danielamendezp/Magnetic-Levitator/Magnetic levitation system.pdf

Universidad Técnica Nacional

Electronic Engineering

Automatic Control Project

# Magnetic Levitation System

Tutor:

Kenneth Rojas Rodríguez

Students:

Keylor García Jirón

Emerson Molina Murillo

Shinji Rodríguez Rodríguez

Daniela Méndez Porras

William Sánchez Céspedes

2022

Introduction (D)

A magnetic levitator allows to sustain a magnetic load in suspension, it can be

obtained by applying current to an electromagnet that generates repulsion

between magnetic poles, starting from the control of the electromagnet it's

possible to maintain the load in the air at certain position. In this investigation, the

study of many tools in the field of engineering is incorporated. However, this field

is still under study, for the application in different areas of science and

engineering.

The project consists of making a design of a magnetic levitator, carrying out the

study of all the elements that are part of it, such as: the mathematical analysis

and use of the transfer function, the study and application of magnetic fields,

development of PID controller, design of electronic circuits, creation of code to

handle variables such as height position, object stabilization and processing of

different signals. The set of all these parts belongs to the implementation of a

physical model of the magnetic levitation system, considering the difficulties and

challenges generated using a great variety of fields of study in the project, as well

as the application of their respective solutions.

The main purpose of the project is to give the system the ability to control the

position of the levitating object, it must be able to make all the necessary

regulations and measurements automatically, making mathematical calculations

that help its proper functioning.

The characteristic of the system is that it will have a single sensor that measures

the height of the floating magnet is located, this magnet will be located just above

the electromagnet and permanent magnets will surround it, which between both

components will apply upward force and repulsion to maintain the permanent

magnet in the air. The floating magnet will be ideally centered and the only thing

that will be regulated will be the height.

Electromagnetic fields are force fields created because of the movement of

electric charges. The electromagnets will fulfill this function, since a coil will cause

a concentration of magnetic flux, more powerful, more stable, and controllable.

This control oversees modifying the electric current that circulates through it.

To effectively apply the stabilization of the levitator, it is necessary to consider its

position, to be processed, through code and the information contained in

mathematical analyzes such as the transfer function, the linearity that exists

between the magnitude of the current and magnitude of the magnetic field, in

other words, the force suffered by the load as a function of the current. Thanks to

obtaining this data, a precise controller can be designed numerically, however, a

series of tests allows the control to have a quick answer, damping changes and

to provide stability.

Throughout the project there were a series of changes in the design of the project

because they were found convenient during the realization of the mathematical

analysis. Changes such as the number of electromagnets, at the beginning of the

project it was projected with 4 electromagnets, by simplifying the mathematical

and physical calculations, thus improving the operation of the project with the

proposed design.

It is worth mentioning that 4 coils with different cable gauges were created, which

were changed at convenience due to the current conditions in which the magnetic

levitation system was working.

For the design of the levitator, the possible situations that could happen were

considered so that the performance could not be the desired. The heat conditions

that the coils can produce, as has been described the flux of current generates a

magnetic field, when placing the load, parasitic currents can be produced that

increase the amount of energy released in the form of heat, affecting the

components and the structure. In addition, the precision during the construction

of the electromagnet can be a fundamental aspect for the correct operation of the

system, also there are other components to consider, including: sensor reliability,

signal noise, etc.

During the project, the team is organized into subgroups consisting of two people,

each of whom must oversee at least two topics, generally related to support

among members, of the same or different groups. As mentioned above, the

important aspects of the tasks to be performed are code developing,

mathematical analysis, electronic circuit design, electromagnet, and magnetic

force, as well as position and current measurement.

The idea in the distribution of tasks is the support between the members,

however, it is necessary that the specialists in each subject can correctly carry

out their tasks and also provide help in research and physical assembly of the

system elements. Therefore, the design, analysis, prototyping, construction or

assembly and testing are the 5 main stages to successfully achieve the project

performance.

To implement the project on a company the economic part is important, since it

needs to render accounts to the creditor to identify if the projects is feasible or

not to a company, according to the obtain benefits and the economic cost of this.

If the expenses exceed the benefits, then the project is not economically viable

for a company. The economic expectations can vary at the beginning of the

project compared to the end, since there is little information about the final

designs proposed.

Literature review:
Circuit of a magnetic levitation system: (D)
The current control of the electromagnet was carried out with the use of an N-

channel MOSFET in a configuration like a step down or buck circuit that helps to

reduce the value of the output voltage in relation to the input. Adding protection

elements such as a reverse polarity diode in parallel to the electromagnet.

It is possible to find that the frequency of 10kHz was used to switch the MOSFET

type transistor, guaranteeing current to the coil and providing smoothness in the

operation of the levitator and avoiding voltage peaks. Some problems with the

heating of the MOSFET transistor and the electromagnet are discussed, which

were solved by using heat sinks. [3]

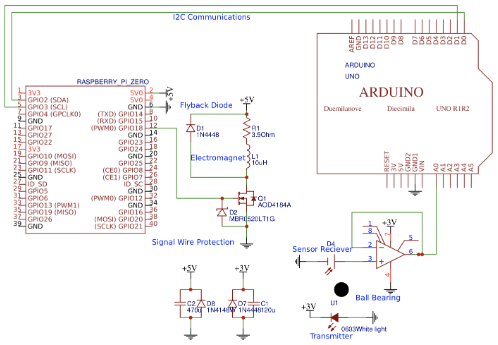
[picture p1: figure]

Figure 1. Magnetic levitation system circuit diagram. [3]

Controller design: (E)

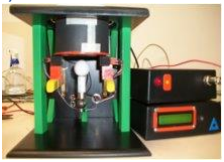
[picture p2: figure]

Figure 2. Design and construction of a magnetic levitation system controlled by

a PID algorithm. [7]

The PID controller exerts a control signal that depends on an error value

calculated as the difference between the desired signal and the system output.

There must be a signal proportional to the error if the output is far from the

reference signal (P = Kpe(t)).

In addition, a control action is needed that acts before the accumulation of the

error, when it becomes constant, which causes the system to act to improve the

response of the system in a steady state with a tendency to the reference signal

Finally, the derivative control action acts against changes in the system output

over time and tries to anticipate these changes

So, the general form of the PID is:

Figure 3. PID equations. [7]

Design Two-Dimensional Magnetic Levitation Control System: (S)
In this thesis they analyze 2 different systems, one is a simple levitator that has

only 1 electromagnet and a steel ball levitating. The other system is with 2

electromagnets, applying 2 different currents for each electromagnet. They also

analyze the stability of the system and how can linearize this system and maintain

the ball levitating.

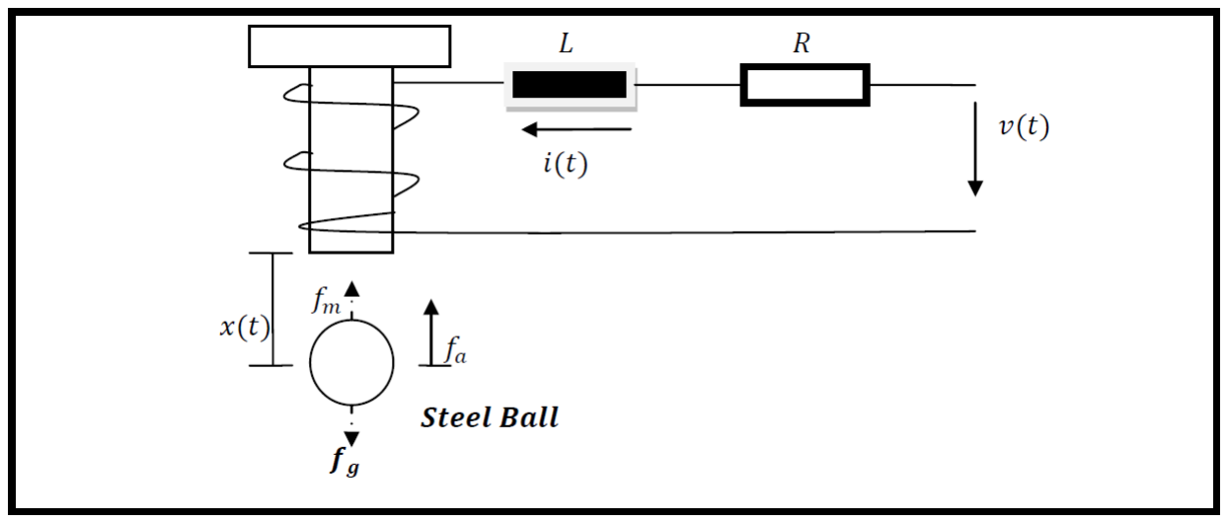
[picture p3: figure]
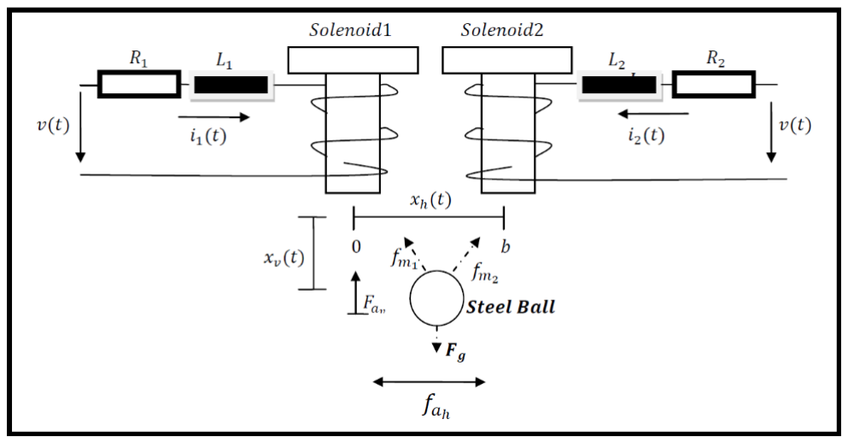
[picture p4: figure]

Figure 3. System diagram.

Project Management
Organization of work teams: (D)
The team was organized in such a way that each one of the members shared at

least one of the tasks with another member, with the aim of dividing the workload

and having support among colleagues due to the high complexity of the project.

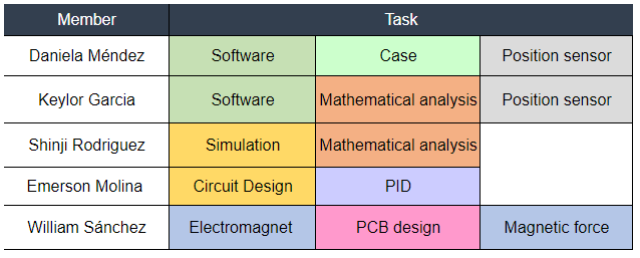
[picture p5: figure]

Table 1. Task division by person.

Gantt Diagram: (D)
The Gantt Diagram schedules each of the tasks to be carried out by the team in

the expected time to project final presentation, it is also possible to have control

of late tasks and tasks to be carried out. The blue color indicates the activities in

the planned time, on the other hand, the red color indicates delayed tasks.

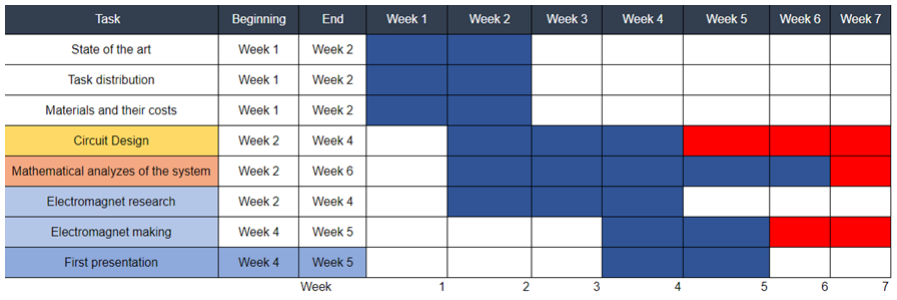
[picture p6: figure]

Table 2. Gantt Diagram from week 1 to week 7.

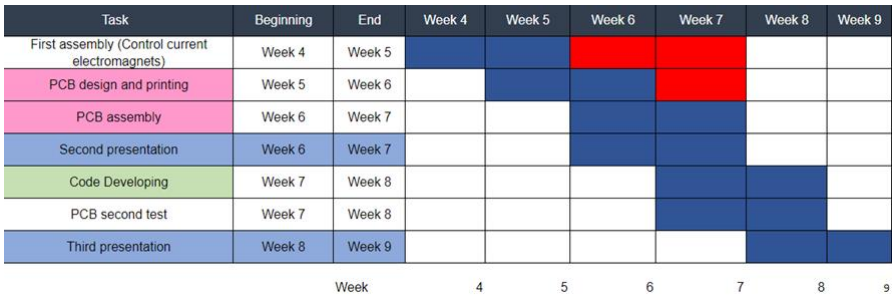
[picture p7: figure]

Table 3. Gantt Diagram from week 4 to week 9.

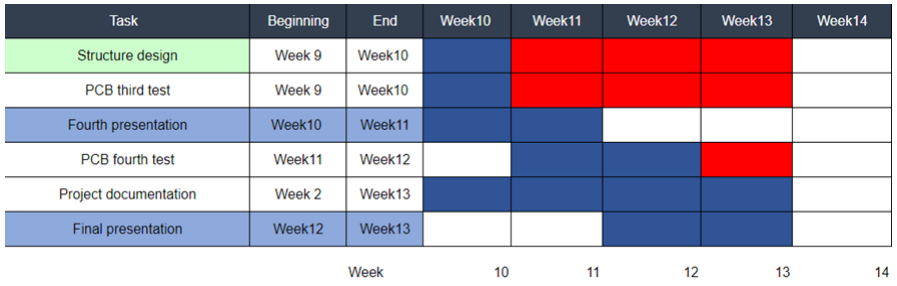
[picture p8: figure]

Table 4. Gantt Diagram from week 10 to week 14.

There were some tasks that were delayed because of the changes to the design

of the project and some complications mainly generated because of

mathematical and physical calculations. Due to the complexity of the project and

the time the research took to find good and reliable information that could be

applied to the needs of the project.

Methodology:
The creation of a levitron is requested, which will fulfill the function of keeping a

magnet floating, it must have a regulation of its height and stability by using a PI,

PD or PID controller.

To carry out what was requested, a mixed research methodology was used where

both the qualitative and quantitative parts were used. This is because qualitative

aspects of the materials to be used and the physic-mathematical aspect of

situations that influenced the levitron system had to be fulfilled.

Specifications of the magnetic levitation system:
Description
Number of coils turns | 470
Cable gauge | 24AWG
Electromagnet size | 30mmx25mm
Magnets | Neodymium N35
Number of coils | 1
Number of magnets | 8x5
Distances between magnets and electromagnet | 49mm
Maximum current | 3A
Maximum separation distance in air | 10mm
Voltage | 12V

Table 5. Specifications of the magnetic levitation system

The previous table will show the specifications that the levitation system and the

electromagnet must comply with. The latter must have these specifications for

proper functioning since the magnet will be levitated on it.

Block Diagrams: (K)

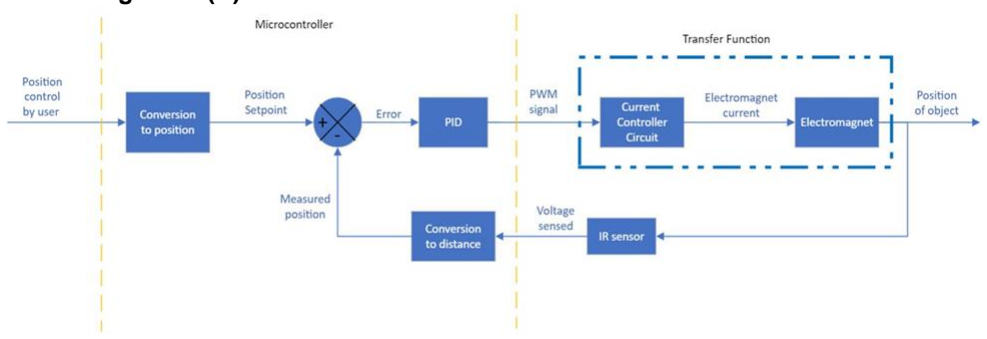
[picture p9: figure]

The block diagram shows the different parts that allow the magnet levitation

height to be controlled, the section consists of two large blocks: the

microcontroller and the transfer function. The levitation height is defined in the

microcontroller, and it is the output of the PWM signal to control the current

variation with respect to the position, the position of the magnet is compared with

the position defined by the user by means of an infrared sensor that determines the distance to which the magnet is located, and the error will be the difference

between these aspects.

Economic Cost: (D)
The cost of the materials was registered to keep track of the components used

for future implementations and improvements of the system. To implement the

project on a company the economic part is important, since it needs to render

accounts to the creditor to identify if the projects is feasible or not to a company,

according to the obtain benefits and the economic cost of this.

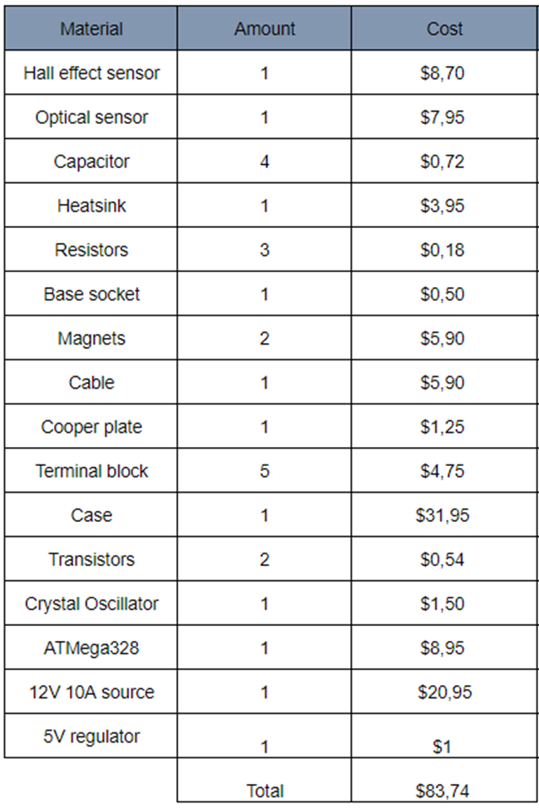
[picture p10: figure]

Table 6. List of materials and their cost.

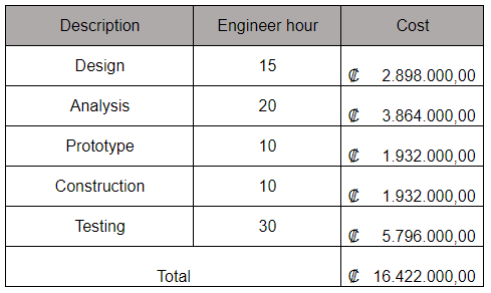
[picture p11: figure]

Table 7. Cost of the engineer hour.

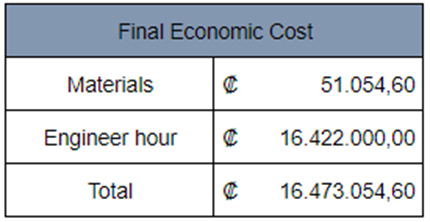
[picture p12: figure]

Table 8. Final economic cost of the project.

As you can see the cost of the material is not that high, however, the most

expensive thing is the hours dedicated to the project, due to the cost of the

engineer hour, being ₡32.200. Owing to the complexity and the time that it takes

to do all the calculations, measurements, the design and the testing considering

changes doing to simplify.

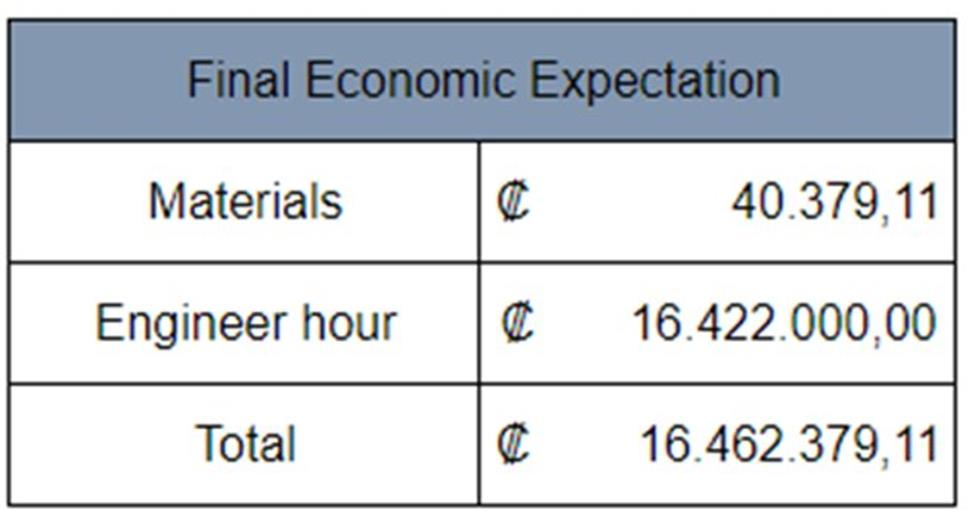
[picture p13: figure]

Table 9. Final economic expectation of the project.

At the beginning of the project approach, an estimate of the costs was calculated,

however, since there is little information about the final designs proposed, the

economic expectation varies from the beginning and at the end of the project. For

this reason, if we compare Table 8 and Table 9, it’s possible to observe different

totals between each of the tables, however, the difference varies by approximately ₡10,000 in material costs.

Theoretical concepts:
For the development of the project an electromagnet was used because it has

the properties experienced by electrical conductors, a current flow through the

conductor and a magnetic field is generated. In addition to being a magnetic

levitation system, this device was used as a pillar for its development.

The electromagnet is a type of magnet in which the magnetic field is generated

by the circulation of an electric current through a conductor. Its superiority over

the permanent magnet lies in the fact that the intensity of the field generated

depends on the amount of current flowing through it, and it is possible to control

its behavior. However, in applications in which it is not necessary to modify the

magnetic field or make it disappear, the permanent magnet is superior, since it

can generate larger fields at the same size.

It was invented in 1825 by a British electrician named William Sturgeon. He based

it on the studies of Hans Christian Ørsted, a Danish physicist who discovered that

the flow of an electric current through a conductor generates a magnetic field

around it. Sturgeon's electromagnet consisted of a horseshoe-shaped (or U-

shaped, to bring the poles closer together and concentrate the lines of magnetic

force) insulated piece of metal wrapped in a coil: a spiral of conductor with many

turns (the more turns the coil has, the more powerful the electromagnet). An

important advance in the evolution of the electromagnet was thanks to Joseph

Henry, an American scientist who changed the iron insulation for conductor

insulation, achieving better results than Sturgeon. In addition, he discovered the

principle of electromagnetic induction in parallel with Faraday, although it was

published earlier by Faraday. He put into practice his knowledge of

electromagnetism to help Morse develop his telegraph based on the

electromagnet. However, it is not necessary to insert a metal part into the coil to

make an electromagnet. An "empty" coil is called a solenoid, with each pole at

one end. The reason for introducing a metallic material (usually iron) inside the

coil is that the field generated is much stronger at the same current intensity. This

effect, known as ferromagnetism, occurs because materials of this type contain

small magnetized zones (domains) that are initially disordered. The magnetic

field of the solenoid arranges them, so that the iron becomes a magnet, and its

effect is added to that of the coil. When the coil field disappears, the domains usually become disordered again, but some materials are remanent, i.e., they

remain magnetized for a while.

Because of their versatility, electromagnets have enabled the emergence of

numerous electronic devices, and important industrial applications have arisen.

The invention of the electric telegraph was made possible precisely thanks to the

electromagnet, and electric motors transform electrical energy into kinetic energy

through the operation of several electromagnets together. Thanks also to their

ability to vary the magnetic field, they are used in loudspeakers and storage

devices. However, the most powerful applications are industrial ones, such as the

separation of materials, the cleaning of contaminated water, magnetic levitation

trains, current generators, or the transport of heavy materials. [11]

As mentioned, the electromagnet is a magnet, where the magnetic field is

generated by electric current, and the current passing through a wire creates a

magnetic field around it, these have advantages in their use and over other similar

devices, although it is also important to have certain considerations in their use,

such as heat.

Unlike common magnets, electromagnets heat up. These artificial devices do

everything a magnet can do and much more; and they are particularly useful

because they can be made to have any desired field strength and can be made

to become stronger or weaker or even turn off. Basically, electromagnets are coils

of wire wrapped around a metal core, which in turn are connected to a battery.

While they are easy to make, they can have a problem with overheating if given

more voltage than their wires can handle. Fortunately, with careful design, this

problem can be avoided. [12]

Electromagnet is called the device that has the property of acquiring magnetic

properties when its coil is crossed by an electric current. [8] Therefore, it easily

transforms electrical energy into mechanical energy.

Used in the project as the central magnet, on which the object to be placed in the

project will levitate. This has an external circuit that allows the regulation of the

current that enters the winding of the electromagnet created.

Magnetism is called the part of electricity that studies the properties of magnetic

fields and the behavior of bodies that are subjected to these fields. [8]

This phenomenon should have been taken into consideration when placing the

magnets that are around the central electromagnet, the attraction or repulsion

that the object has on each of the base magnets is essential in the levitation that

can occur.

The lines of force of a magnet are invisible lines that can be seen by scattering

iron filings in a magnetic field, leaving one pole of the electromagnet and going

to the other pole in a beam. [8] These lines become unobservable, but they occur

since a magnetic field is created in the magnetic levitator.

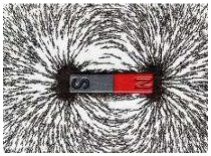
[picture p14: figure]

Figure 4. Representation of lines of force [9]

Magnetic flux is the total number of lines of force that cross any section of a

magnetic circuit.[8] In the case of the magnetic levitator, the field lines pass

through the object that will be found hovering over the electromagnet.

Magnetic permeability is the relationship between magnetic induction and the

corresponding magnetic field intensity determined on the magnetization curve.

[8]. It is used in the force formula for the object to be held in levitation.

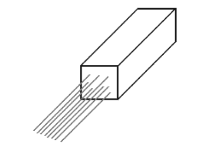
[picture p15: figure]

Figure 5. Representation of the magnetic flux [8]

Magnetic flux. It is defined as the surface integral over the normal component of

the magnetic field where Φ is the magnetic flux, B the magnetic induction, gives

the surface area differential and n the norm. The magnetic flux is analogous to

the electric field, it is also represented as arrowhead lines, which run from the

north to the south pole of the magnet. For a magnetic induction B and a constant

area A. [13]

Magnetic susceptibility. In many isotropic and linear materials there is a

relationship between magnetization (M) and magnetic field strength (H), where

xm is the magnetic susceptibility. According to their magnetic susceptibility

materials are classified into paramagnetic if xm > 0, being the magnetic induction

enhanced and into diamagnetic if xm < 0, in which the magnetic induction is

weakened, xm can vary drastically with temperature, in general xm is quite small

(|xm| 1) for diamagnetic and paramagnetic materials. [13]

Self-inductance. Occurs in a coil when the current flowing through it is varied,

inducing an electromotive force on itself. In a coil of N turns, through which

circulates a current I, the inductance, where l is the length of the coil and Φ the

magnetic flux present in it. Considering Faraday's law, the self-inductance in a

coil gives rise to a counterelectromotive force [13].

Magnetic circuits. If we consider a well-defined path for a magnetic flux (as in the

case of ferromagnetic materials), a magnetic circuit can be considered. A closed

circuit of ferromagnetic material excited by a series of wire loops through which

a current flow represents a magnetic circuit. The magnetomotive force is given

by fmm = NI, where N is the number of turns of the coil and I, the current flowing

through it. The reluctance is defined as < = R dl µA, where dl is the length

differential and A the cross-sectional area in question. Analogous to Ohm's circuit

law and Φ being the magnetic flux. [13]

Ferromagnetic material: are substances that possess a great magnetism,

capable that a magnet remains adhered to it.

Electromagnetic field: These are a combination of invisible electric and magnetic

force fields. They occur both naturally and due to human activity.

Inductance: Inductance is the property of an electrical circuit to resist changing

current. A current flowing through a wire has a magnetic field around it.

Magnetism: Magnetism is a physical phenomenon whereby objects exert

attractive or repulsive forces on other materials.

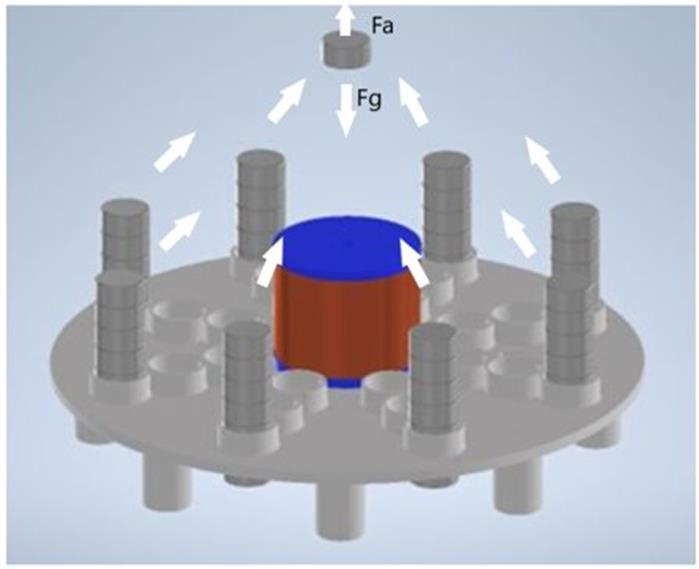
[picture p16: figure]

Figure 6: Force diagram.

Each magnet has independent forces, which when united in a single mass, in this

case according to the previous image is observed as a tower of magnets placed

on the base that would act as permanent magnets.

These permanent magnets exert independent forces oriented to the same

direction on the magnet that is in a state of levitation, where this magnet has its

forces such as gravity, for example.

So, in the circuit sketch was made use of an electromagnet, which is a device

capable of generating magnetic fields using electric currents in its windings.

The electromagnet together with the permanent magnets will allow the interaction

of the forces and the regulation of the height of the levitating magnet.

Mathematical calculations and measurement
Electromagnetic field measurements: (D)
The electromagnetic field measurements were made using a hall sensor, where

it can measure the fields at different distances. This sensor works by generating

an output voltage which will be proportional to the product of the strength of the

magnetic field and the current.

If the value of the current is known, then the strength of the magnetic field can be

calculated; If the magnetic field is created by using a current flowing through a

coil or a conductor, then the value of the current in the conductor or coil can be

measured.[10] Applying this concept, the measurement of the magnetic field of

the electromagnet used was carried out, relating at the same time the magnitude

of the magnetic field to different measured currents and different distances.

For the measurement of the magnetic field of permanent magnets, the same

concept was used, but applying the relationship between the magnetic field and

the distance, this was measured to obtain the magnetic moment of the permanent

magnets found in the base. Whose equation is:

μ =

B⋅X

3
2x10⁻⁷

Equation 1. Dipole moment of a magnet.

This dipole moment constant will help to apply the formula for the force exerted

by the 8 permanent magnets. This will help in mathematical calculations, since

it's intended to obtain the value of the forces that will be exerted on the magnet

that will be in the air.

Obtaining these values, was written down with their distance, current and

magnetic field variations to obtain a representative equation whose variable

would be height and current in the case of the electromagnet.

For this measurement, a printed system was built, which can be seen in Figure

7. It helped to obtain the highest possible precision in the data, since this will

determine if the height adjustments that the levitator needs will be precise.

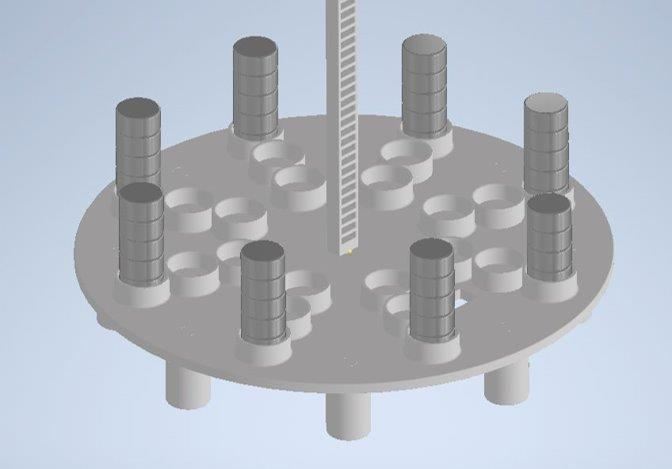
[picture p17: figure]

Figure 7. The design was made to measure the magnetic field at different

distances.

As can be seen, the measurements were made at different distances and heights,

to obtain the distance referring to the position of the permanent magnets with

respect to the center of the electromagnet and to analyze at what determined

distance is the ideal magnetic field to be able to provide the floating magnet a

greater difference in height to which can be regulated.

The measurement of the magnets was also carried out at different positions with

respect to the center of the magnet to obtain a measurement that was closer to

the ideal behavior of a magnetic field at different heights, since this, as mentioned

above, would help mathematical calculations to be more accurate and therefore

the height control was more precise.

Current measurements: (K)
For current control, it was determined that the most appropriate way to do it is by

implementing a PWM-controlled mosfet transistor to vary the current that reaches

the electromagnet and limit it so that it does not exceed levels that could

compromise the cables and the electromagnet.

This control is essential since it will allow you to vary the height of the magnet

that is levitating, pushing or attracting it as necessary.

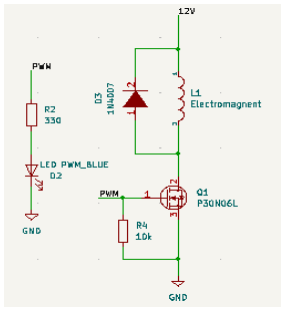
[picture p18: figure]

Figure 8. Schematic of the current control for the electromagnet.

A simulation was carried out in the LTspice software to observe the reaction of

the circuit with respect to the input PWM signal, as shown in figure 8, the current

(red signal) increases according to the variation of the pulse width. PWM (green

signal). The simulation contains the final design for current control because with

the progress of the project it was modified according to the needs, the frequency

of the pwm signal was defined at 31kHz.

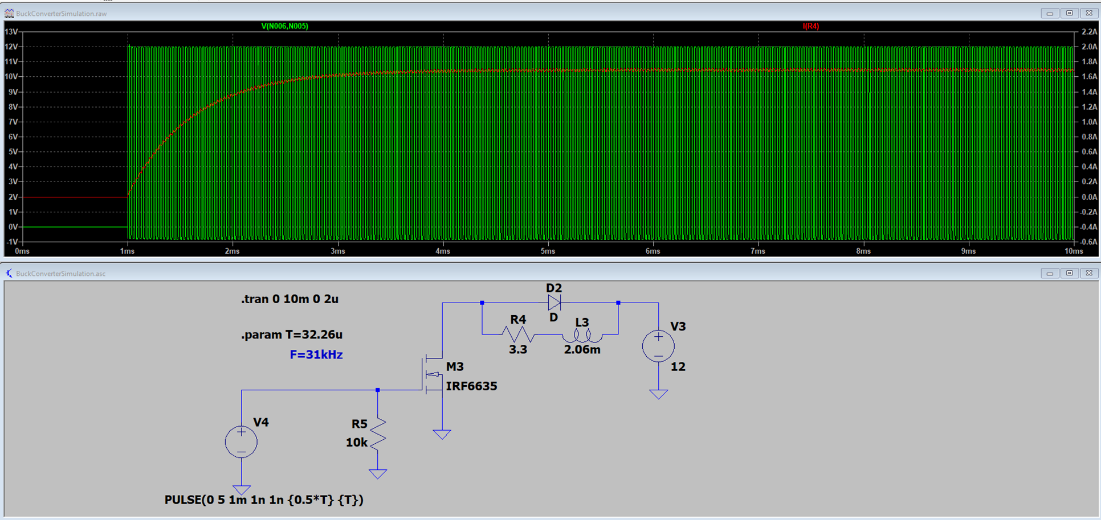
[picture p19: figure]

Figure 9. Current simulation in LTspice.

Mathematical and physical analysis: (S)
After measuring the magnetic field of 8 permanent magnets, we obtained the

equation y=0.0338*exp(-96.24x); where y is the representation for the magnetic

field and x the distance away from the magnet. And for the electromagnet using

1A is y= 0.0695*exp(-129.02x).

And calculating the force between the 8 permanent magnets and levitating

magnet, and force between electromagnet and levitating magnet applying this

formula:

Where:

fm: magnetic force

μb: magnetic permeability of the levitating magnet

ℎb: levitating magnet height

b: levitating magnet radius

d: distance between magnets in z axis

Bρ

(z): magnetic field of 8 magnets of electromagnet

For mathematical analysis we will need net forces:

fa = fm − fg

Where:

- Magnetic force (using the previous integral equation for the force):

fm = f8m + fem

f8m: 8 fixed magnets force

fem: electromagnet force

fm = 1.9112e

−96.42z − i ∗ 3.9598e

−129z

- Gravitational force:

fg = mg

fm = 2

μb
bℎb

∫ Bρ
(z)dz

d+ℎb⁄2

d−ℎb⁄2

- Acceleration force

fa = m

d

2
z
dt

2

The equation of motion for the levitating magnet is given by

m

d

2
z
dt

2 = fm − mg

Substituting magnetic force in the equation:

m

d

2z
dt

2 = 1.9112e

−96.42z − i ∗ 3.9598e

−129z − mg

→

d

2
z
dt

2 =

1.9112e

−96.42z
m

−

i ∗ 3.9598e

−129z
m

− g

While the equation for the electrical circuit is given by:

L

di
dt = −Ri + Vinavg

→

di
dt = −

R
L

i +

1
L

Vinavg

For the equilibrium point we have:

d

2z
dt

2 = 0 and di
dt

= 0

Substituting the acceleration:

0 =

1.9112e

−96.42z
m

−

i ∗ 3.9598e

−129z
m

− g

=> ie =

1.9112e

−96.42ze − mg
3.9598e

−129ze

And substituting di/dt

0 = −Ri + Vinavg

Vinavg = Rie = R [
1.9112e

−96.42ze − mg
3.9598e

−129ze

]

These equations are nonlinear equation, so we need to initialize them, in order to

obtain a linear model of the system, we will use Taylor Series Expansion of the

first two terms

d

2
z
dt

2 = a1

(z − ze

) + a2

(ż− że

) + a3

(i − ie

) + b(v − ve

)

a1 =

∂f1
∂z

|equil =

∂

∂z (
1.9112e

−96.42z
m

−

i ∗ 3.9598e

−129z
m

− g) |equil

=

−184.278e

−96.48ze
m

+

ie ∗ 510.8142e

−129ze
m

a2 =

∂f1
∂ż

|equil =

∂
∂ż

(
1.9112e

−96.42z
m

−

i ∗ 3.9598e

−129z
m

− g) |equil = 0

a3 =

∂f1
∂i

|equil =

∂
∂i̇

(
1.9112e

−96.42z
m

−

i ∗ 3.9598e

−129z
m

− g) |equil =
3.9598e

−129ze
m

b =

∂f1
∂v

|equil =

∂

∂v (
1.9112e

−96.42z
m

−

i ∗ 3.9598e

−129z
m

− g) |equil = 0

We note that the equation for the electrical part of the system is already linear.

Now define the following variables

x1 = (z − ze

); x2 = (ż − że

); x3 = (i − ie

); u = (v − ve
)

Where:

x1 = Magnet position

x2 = Magnet velocity

x3 = Drive current

u = Input average voltage

Whit this equation we can define a transfer matrix to obtain the transfer function

of the behavior of this system.
[

x1

̇
x2

̇
x3

̇

] = [

0 | 1 | 0
a1 | 0 | a2
0 | 0 −
| | R
| | L

] [
x1
x2
x3

] + [

0
0
1
L

] u(t)

y = x1 = [1 0 0][

x1
x2
x3

] + 0

And after calculating this transfer matrix we obtained this transfer function:

G(s) =

a2
L
s

3 +

R
L

s

2 − a1s −a1

R
L

We specify the following design parameters:

R = 3.3Ω; | L = 0.00206H; | m = 0.0028kg; | g = 9.81

m
s

2
For ze = 0.01m + 0.0225m(offset from center of tℎe electromanget) = 0.0325m

ie =

1.9112e

−96.42ze − mg
3.9598e

−129ze

ie =

1.9112e

−96.42∗0.01 − 0.0028 ∗ 9.81 3.9598e

−129∗0.01

ie = 0.6433383A

Vinavg = Rie = R [
1.9112e

−96.42ze − mg
3.9598e

−129ze

]

Vinavg = 3.3 ∗ 0.6433383

Vinavg = 2.123V

a1 =

−184.278e

−96.48ze
m

+

ie ∗ 510.8142e

−129ze
m

= 7228.70173

a2 =

3.9598e

−129ze
m

= 389.291874

G(s) =

a2
L
s

3 +

R
L

s

2 − a1s −a1

R
L

G(s) =

188976.6379
s

3 +1601.941748s

2 − 7228.70173s −11579959.08

For apply a PID control, we will use this equation for the PID:

C(s) = Kp +

Ki
s

+ Kds

C(s) =

Kds

2 + Kps + Ki
s

Calculating the close loop transfer function:

CLTF(s) =

C(s)G(s)
1 + C(s)G(s)

CLTF(s) =

(
Kds

2 + Kps + Ki
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
2 − a1s − a1

R
L

)

1 + (

Kds

2 +Kps +Ki
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
2 − a1s − a1

R
L

)

CLTF(s) =

a2
L

(Kds

2 + Kps + Ki)

s(s

3 +

R
L

s

2 − a1s − a1

R
L

)

s (s
3 +

R
L

s

2 − a1s −a1

R
L

)+

a2
L

(Kds

2 + Kps + Ki)

s(s

3 +

R
L

s

2 − a1s − a1

R
L

)

CLTF(s) =

a2
L

(Kds

2 + Kps + Ki)

(s
4 +

R
L

s

3 − a1s

2 − a1

R
L

s) +

a2
L

(Kds

2 + Kps + Ki)

CLTF(s) =

a2
L

(Kds

2 + Kps + Ki)

s

4 +

R
L

s

3 +(Kd

a2
L

− a1) s
2 + (Kp

a2
L

−a1

R
L

)s + Ki

a2
L

)

Where:

2δωn = Kp

a2
L

− a1

R
L

ωn

2 = Ki

a2
L
We will omit Kdsince it is not within the current analytical capabilities, so we can

rewrite the equation as follows

C(s) =

Kps + Ki
s

CLTF(s) =

(

Kps + Ki
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
2 − a1s − a1

R
L

)

1 + (

Kps + Ki
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
2 − a1s − a1

R
L

)

CLTF(s) =

a2
L

(Kps +Ki)
(s
4 +

R
L

s

3 − a1s

2 − a1

R
L

s) +

a2
L

(Kps +Ki)

CLTF(s) =

a2
L

(Kps + Ki)

s

4 +

R
L

s

3 −a1s

2 + (Kp

a2
L

− a1

R
L

)s + Ki

a2
L

)

ts =

3
δωn

→ δωn =

3
ts

→ ωn =

3
tsδ

2δωn = Kp

a2
L

− a1

R
L

→

6
ts

=

Kpa2 − a1R
L

Kp =

6L + a1Rts
tsa2

=> Kp = 61.276

(

3
tsδ

)

2
= Ki

a2
L

Ki = (

L
a2

) (

3
tsδ

)

2
=> Ki = 132.289; para δ = 0.6

Ki = 97.2; para δ = 0.7

Ki = 74.4; para δ = 0.8

Ki = 58.8; para δ = 0.9

Designs
Schematic Design: (K)

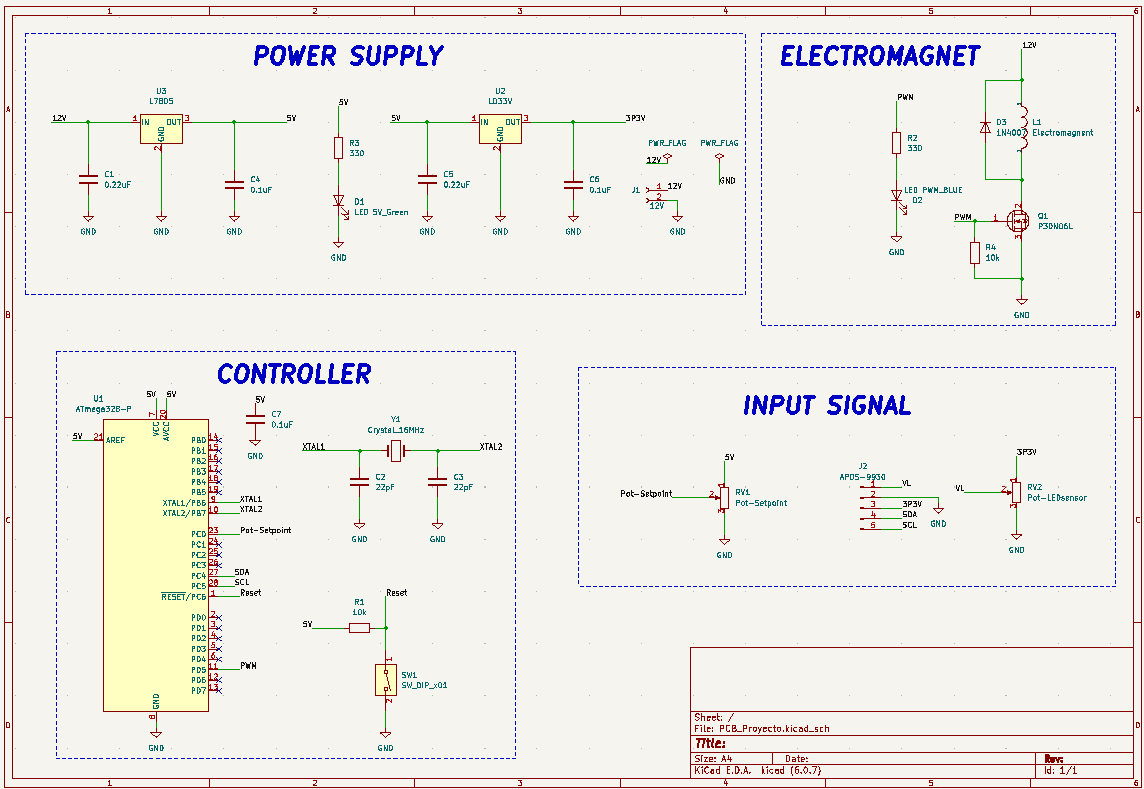
[picture p20: figure]

Figure 10. Schematic Design

The circuit design was divided into four parts, a control part, a power part, the

electromagnet and the input signal, where each one fulfills a specific and

important function within the circuit.

In the control stage all the power supplies of the circuit, there you can find the

components responsible for feeding or regulating the other components so that

they can operate properly.

The control stage is responsible for the operation of the circuit, this part uses the

energy generated by the previous stage to achieve the actuation of the

components, controlling their functions within each stage of the device, in our

case the main component of the control stage is an ATmega.

The electromagnet part is responsible for generating a magnetic field that arises

from the circulation of an electric current through a conductor. This, together with

the permanent magnets, manages the intensity of the field, which depends on

the amount of current flowing.

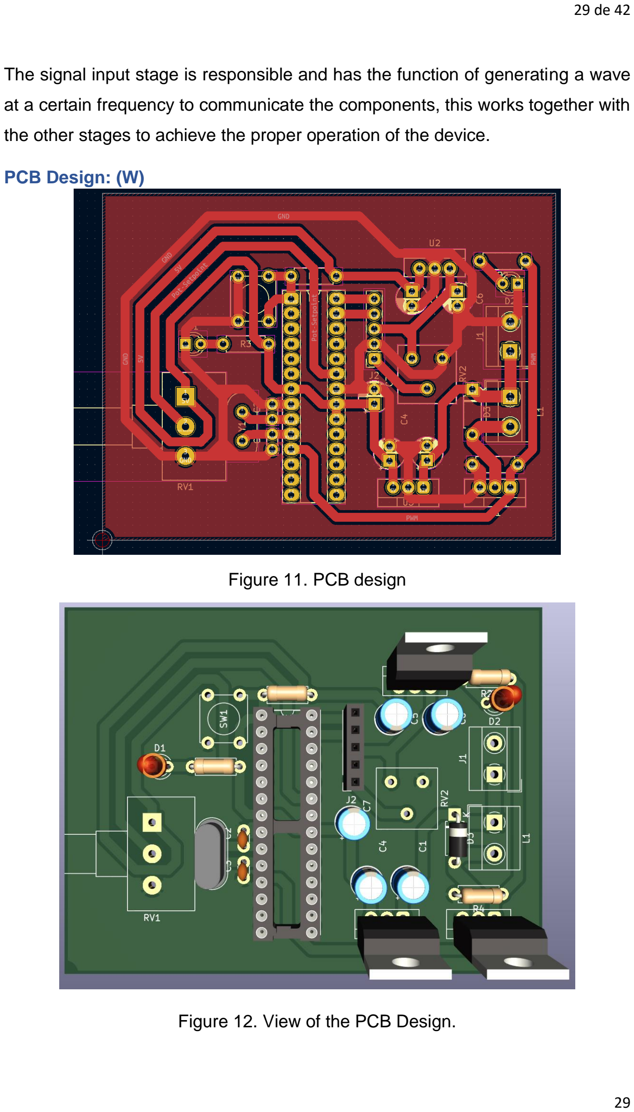
[picture p21: page 29]

The signal input stage is responsible and has the function of generating a wave

at a certain frequency to communicate the components, this works together with

the other stages to achieve the proper operation of the device.

PCB Design: (W)

Figure 11. PCB design

Figure 12. View of the PCB Design.

For the design of the PCB was used KiCad software because it is a very versatile

software and with a very wide gallery of components, then once designed the

circuit allows you to create the PCB as such, where once placed all the pieces

can accommodate your own taste and design the respective tracks; these tracks

can be expanded to the thickness this in order that when printed on the CNC

machine avoids any malformation of this.

In figure 11 you can see one of the different layers of the PCB, this shows the

design of how the connections will look like, the holes where each component will

go, the parts that will have copper, those that will not and the actual size of the

piece.

In Figure 12 you can see a schematic of how the circuit will be with the assembled

components, this is remarkable of KiCad software because it allows users a

realistic view of the project they are working on, so it is easier to make changes

of positions or different modifications.

Structure design: (D)
The physical structure was designed with the Autodesk company's Inventor

program, which allowed the design of all the structures made during the project,

both in tests during the process, measurement structures for precision, and the

final structures that provide the project, stability, magnet location facilities, space

for cables, sensor support, circuit boards, likewise it’s part of the electromagnet

support.

These were designed and printed with the objective of resisting the temperatures

generated by all the circuitry, therefore, they were printed in PETG, whose

resistance provides the project with the conditions not to melt or damage

elements in the process.

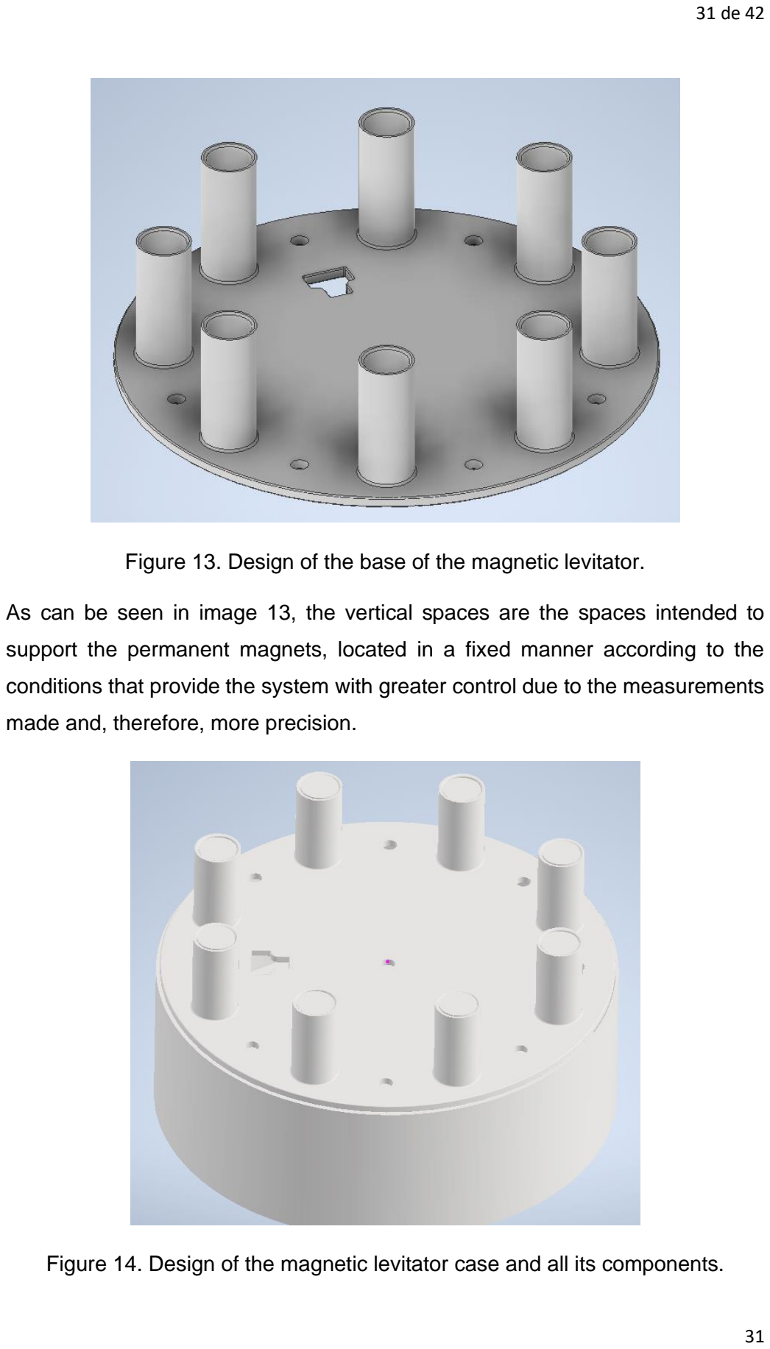
[picture p22: page 31]

Figure 13. Design of the base of the magnetic levitator.

As can be seen in image 13, the vertical spaces are the spaces intended to

support the permanent magnets, located in a fixed manner according to the

conditions that provide the system with greater control due to the measurements

made and, therefore, more precision.

Figure 14. Design of the magnetic levitator case and all its components.

Code

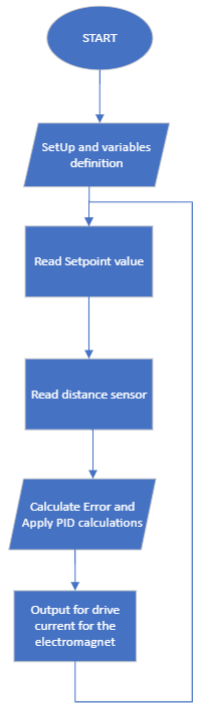
[picture p23: figure]

Figure 15. Flow diagram of the code.

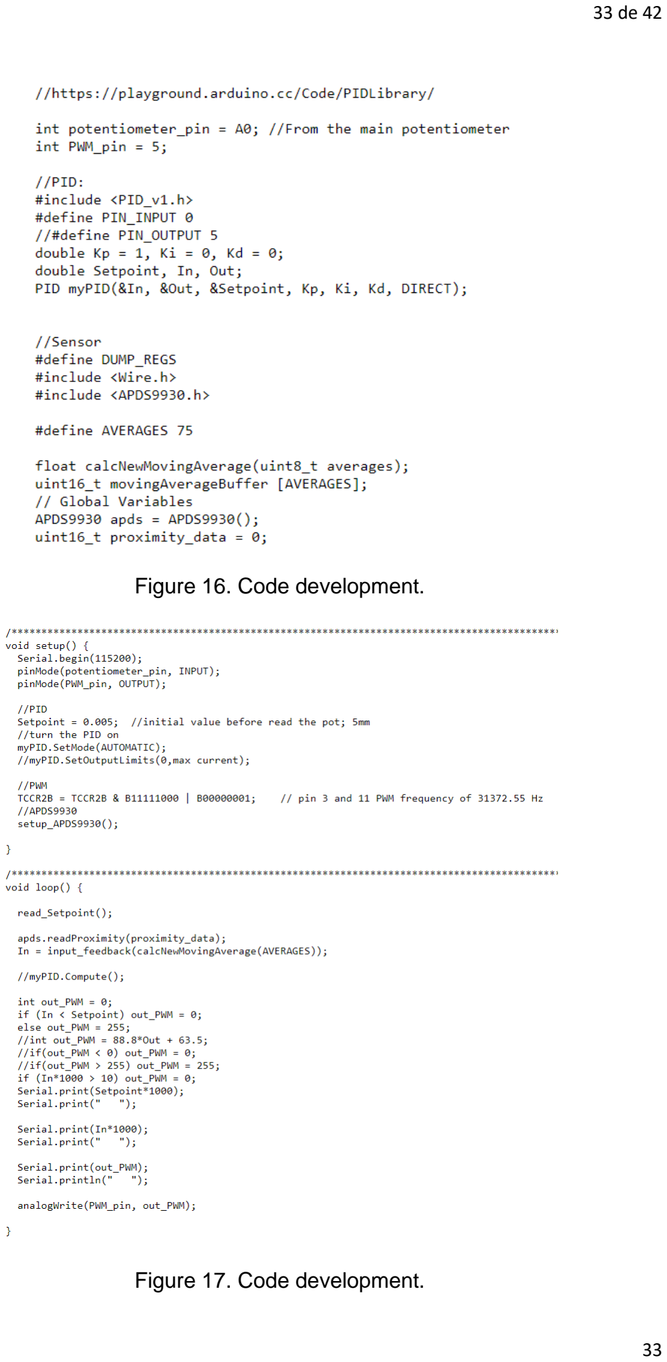
[picture p24: page 33]

Figure 16. Code development.

Figure 17. Code development.

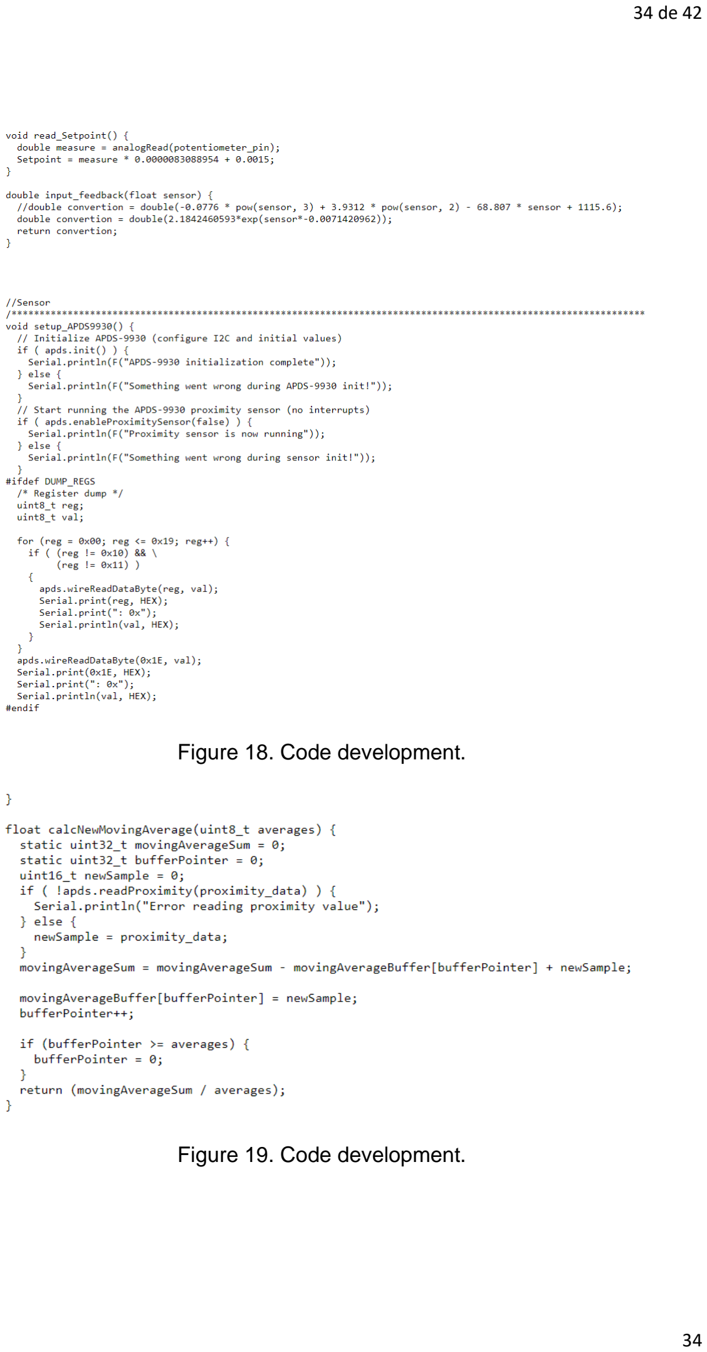
[picture p25: page 34]

Figure 18. Code development.

Figure 19. Code development.

Results
The first experimental tests were carried out with other types of cable thickness

for the winding of the electromagnet, such as thickness 31, which did not obtain

expected results since it had a very low current and said current did not fulfill the

purpose of levitation.

After various tests, the winding is carried out with a total of 470 turns with a 24-

gauge wire. The main advantage was that it was a winding capable of

withstanding high currents of up to 3A; Another advantage was that at the time of

winding (which is done by hand) there is greater comfort due to the thickness.

For the development of the project, we resorted to many documents with

information on the subject and the relevant concepts for its development, where

the properties of the magnets, electromagnets and components to be used were

studied in order to choose the most suitable for its operation and the development

of the PCB.

For the development of the PCB circuit tests were made in the software and in

physical, mainly once the tests in the protoboard were completed, we proceeded

to make the design of the PCB, in this the chosen components were placed, the

parameters of each physical component were considered, such as the spaces

that covered in the proto, the size. Also, the tracks were adjusted to avoid that

when printing any track suffered any damage, also the different views of KiCad

were used to visualize each part of the PCB and how they work together giving

an expectation of the actual physical design.

We also opted for the design of this in CNC machine to obtain a better precision

in the development of this, although PCB designs were also made with acid.

The measurement of electromagnetic fields, in addition to providing important

information that would later be used in mathematical calculations, whose purpose

was to feedback the errors that occurred in the system to correct it.

All the measurements carried out were made in such a way that the precision

errors were minimal, however, it is impossible to give the necessary conditions

so that there are no measurement errors, in addition to this, in the operation of

the magnetic levitator, unexpected errors can occur.

Even when trying to characterize the system with precise measurements and

avoiding many variations in the process, many of the calculations in the end were

approximations that were made since by taking several measurements of the

same set up or configuration of magnets that we used, variations were obtained,

It could be due to external magnetic fields that we could not control, failures in

the measuring instruments or even, after doing several tests, the magnets were

damaged, so this can also affect the results obtained.

Conclusions
- In conclusion one of the points that caused the system to not work properly

was in the final design by leaving the permanent magnets in a fixed

location, since regulating the distance of the magnets facilitated the

creation of ideal magnetic field conditions to levitate the magnet.

- When making the changes in the sensors, it was detected that the IPR

was affected by the hand of the person who placed the magnet to float, on

the other hand, the hall effect sensor could produce not so precise

measurements due to all the magnetic fields that surrounded it.

- Apart from the problem with the sensors, the circuit design was found to

be correct, since it correctly regulated the current according to the system

specifications. Having the correct response speed and commutation,

verifying with the tests that they did work.

- The use of a correct gauge and a number of turns in the electromagnet

provides a better magnetic field in the system, since the magnet is

levitating on the electromagnet.

- In the physical-mathematical calculations, changes are observed with

respect to those obtained in the real measurements, this is due to external

factors such as the manual placement of the magnet that was levitating,

the placement of the permanent magnets, changes in the current, which

affects directly the electromagnetic field, among others.

- For the PCB design we chose the KiCad application because it is very

complete software, which has the necessary components or allows us to

create them.

- With the development of the project, you will acquire knowledge about

magnetism, magnetic fields, properties of electromagnets and how to

develop a project of this type.

- Calculating a PID for a complex system can be difficult if we don’t know

the canonical form of the transfer function, and the lack of knowledge to

apply approximations to complex systems such as this affects when

performing mathematical calculations.

- The lack of considerations and experience when using some materials and

components makes it difficult to develop a product capable of performing

its function correctly, and the learning curve slows down the process.

- The control of current was fundamental in the project, since although the

proper operation was not perfected, in the end it was possible to make the

magnet levitate in a controlled manner and varying the height thanks to

the designed current control circuit.

- The magnet was able to levitate and vary the levitation height in a

controlled way using a tube that prevented it from leaving the central

position, this is because the magnet could only influence the rise and fall

position and not the attraction towards the ends.

- When placing the magnet on the electromagnet it was always done

inaccurately because when placing it by hand it would always have

different positions, even though the fixed magnets were in exact positions,

depending on where the magnet was placed it always tended to go to one

of the fixed magnets.

- Initially, in the tests where it was possible to levitate the magnet without

any external help apart from the system, there was the option of moving

the fixed magnets, however, this operation had to be carried out each time

the magnet was placed on the electromagnet, the same operation as could

not be repeated when modifying the design with exact positions for the

fixed magnets.

References
[1] Balko, P., & Rosinová, D. (2017). Modeling of magnetic levitation system.

Bratislava, Slovakia: Institute of Automotive Mechatronics.

[2] Guevara Granizo, M. V., & Herrera Soukup, B. (2011). Diseño, Modelamiento,

Simulación e Implementación de un Sistema de Levitación Magnética (Maglev)

con un Grado de Libertad. Quito: Universidad San Francisco de Quito Colegio

Politécnico.

[3] Hayt, W. H., & Buck, J. A. (2006). Teoría Electromagnética. Distrito Federal:

Mc Graw Hill.

[4] Ismail, M. (2015). Design Two-Dimensional Magnetic Levitation Control

System. Gaza: The Islamic University.

[5] Ogata, K. (2010). Modern Control Engineering. New Jersey: Prentice Hall.
[6] Sánchez Bas, P., & Zamora, J. L. (2018). Diseño y construcción de un

levitador magnético. Madrid: Universidad Potificia Comillas.

[7] J. D. R. Ruiz (2010). Diseño y Construcción de un sistema de levitación

magnética controlado por un algoritmo PID.

[8] M. Á. Pulido, ELECTROIMANES, San Vicente : Club Universitario, 2010.
[9] Sears, Zemansky (2009) Física universitaria con física moderna Serway, R.

A., Jewett, J. W. (2008) Física para ciencias e ingeniería

[10] Torres M, B., Valderrama S, M. (2020). Sensor de efecto Hall. Universidad

Nacional de San Antonio de Abad del Cusco. Recuperado de: (28) SENSOR DE

EFECTO HALL | Martin Valderrama Samata - Academia.edu (https://www.academia.edu/45188818/SENSOR_DE_EFECTO_HALL) el 24 de noviembre

del 2022.

[11] | Ingeniatic. | (2011). | Electroimán | Destacado. | Recuperado | de:

https://www.etsist.upm.es/estaticos/ingeniatic/index.php/tecnologias/item/451-

electroim%C3%A1n%3Ftmpl=component&print=1.html#:~:text=Fue%20inventa

do%20en%201825%20por,campo%20magn%C3%A9tico%20a%20su%20alred

edor. (https://www.etsist.upm.es/estaticos/ingeniatic/index.php/tecnologias/item/451-electroim%C3%A1n%3Ftmpl=component&print=1.html)

[12] Imamagnets. (2018). IMA: Magnet factory and magnetic applications.

Recuperado de: https://imamagnets.com/blog/por-que-los-electroimanes-se-

calientan/ (https://imamagnets.com/blog/por-que-los-electroimanes-se-calientan/)

[13] HERNANDEZ, Paul Javier Campos. Construccion y control de un levitador

magnetico. 2008.

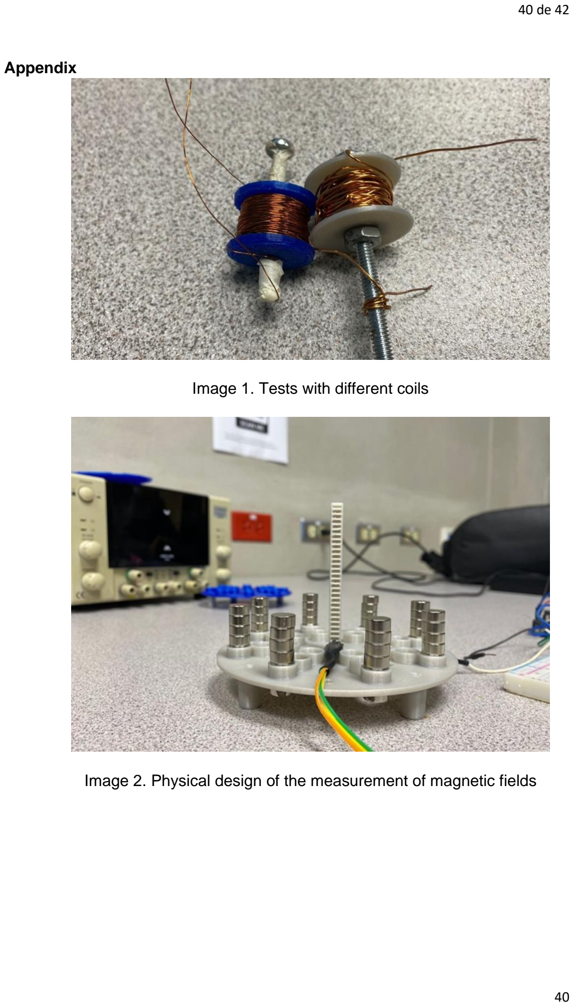
[picture p26: page 40]

Appendix

Image 1. Tests with different coils

Image 2. Physical design of the measurement of magnetic fields

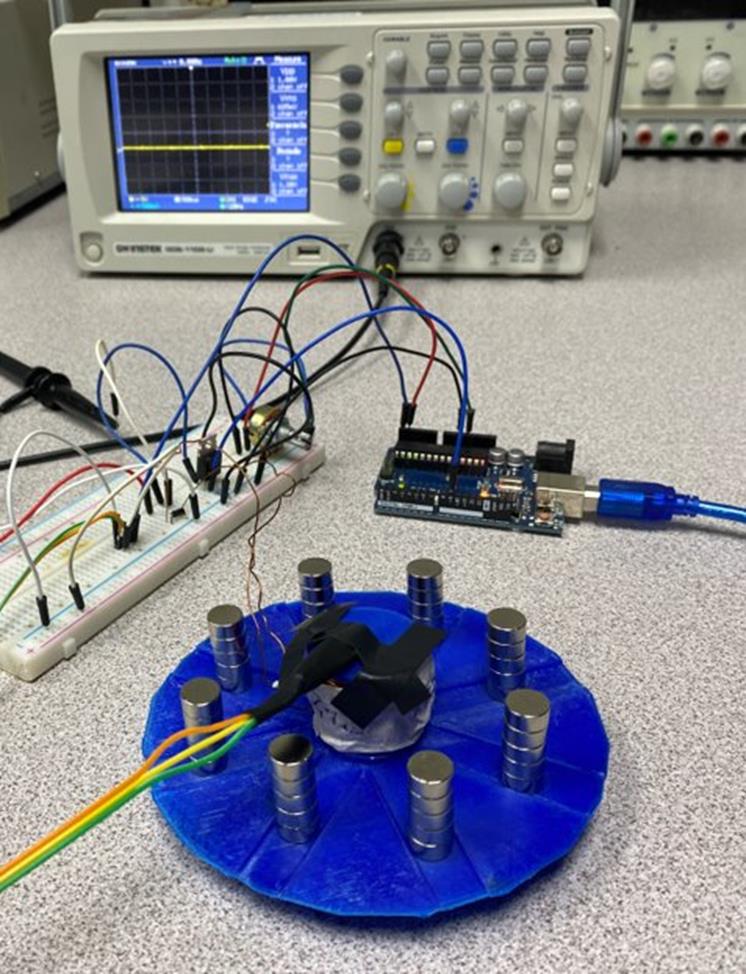
[picture p27: figure]

Image 3. Protoboard tests

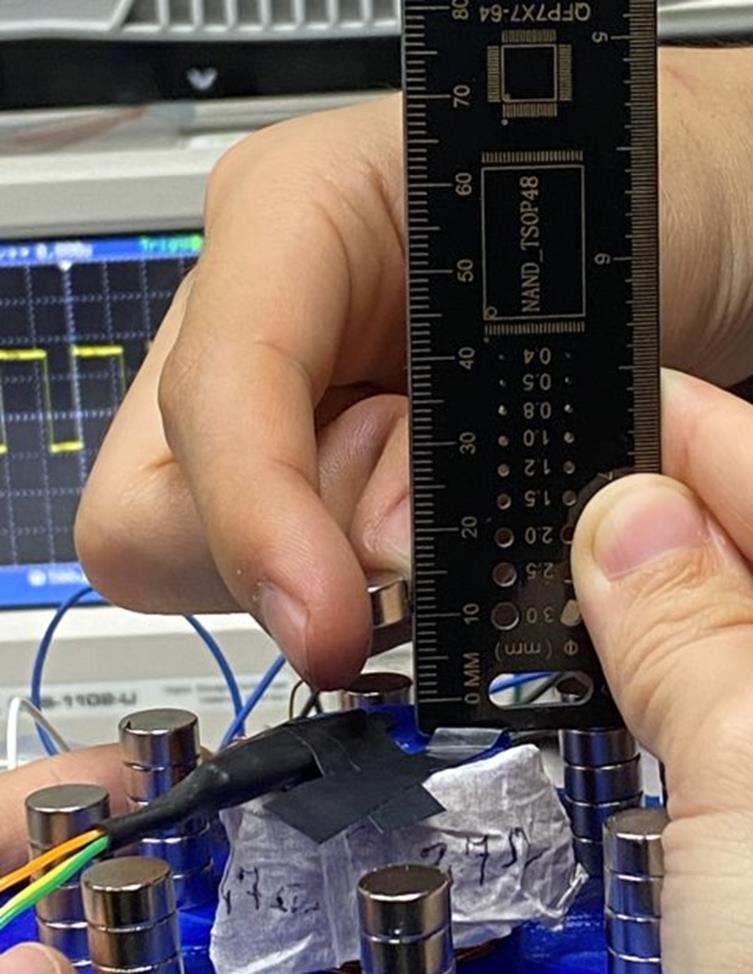
[picture p28: figure]

Image 4. First tests to measure the magnetic field of the coil at different

distances
