danielamendezp/Magnetic-Levitator/circuitoLevitron.PDF

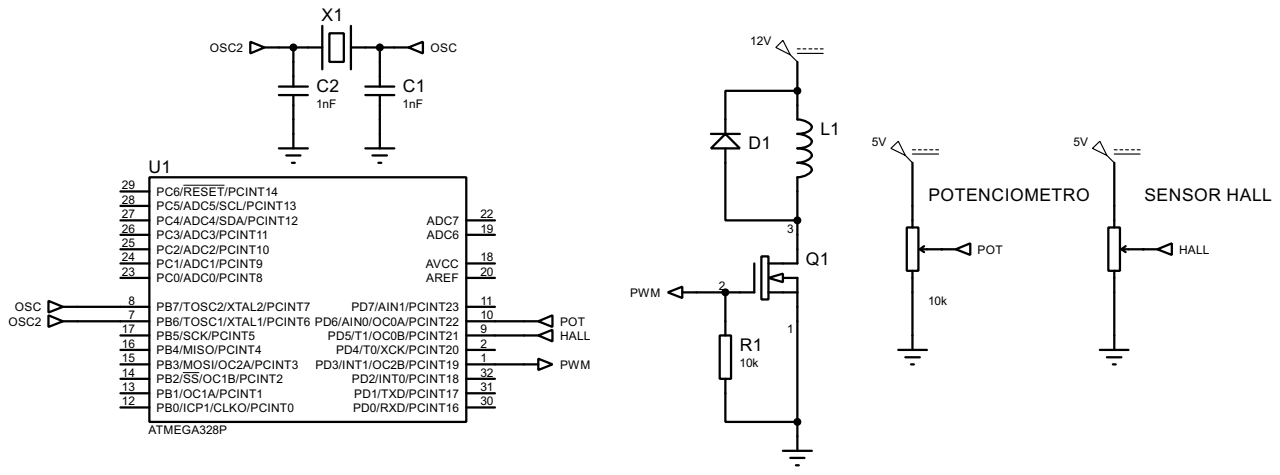
[picture p29: page 1]
