danielamendezp/Magnetic-Levitator/(list of files, drawings)

Other design files:
circuitoLevitron.pdsprj
